barisdinc/Aselsan_Boynuz/3D/Rotary/README.md

## Frekans ve Menü İşlemleri için Rotary Encoder

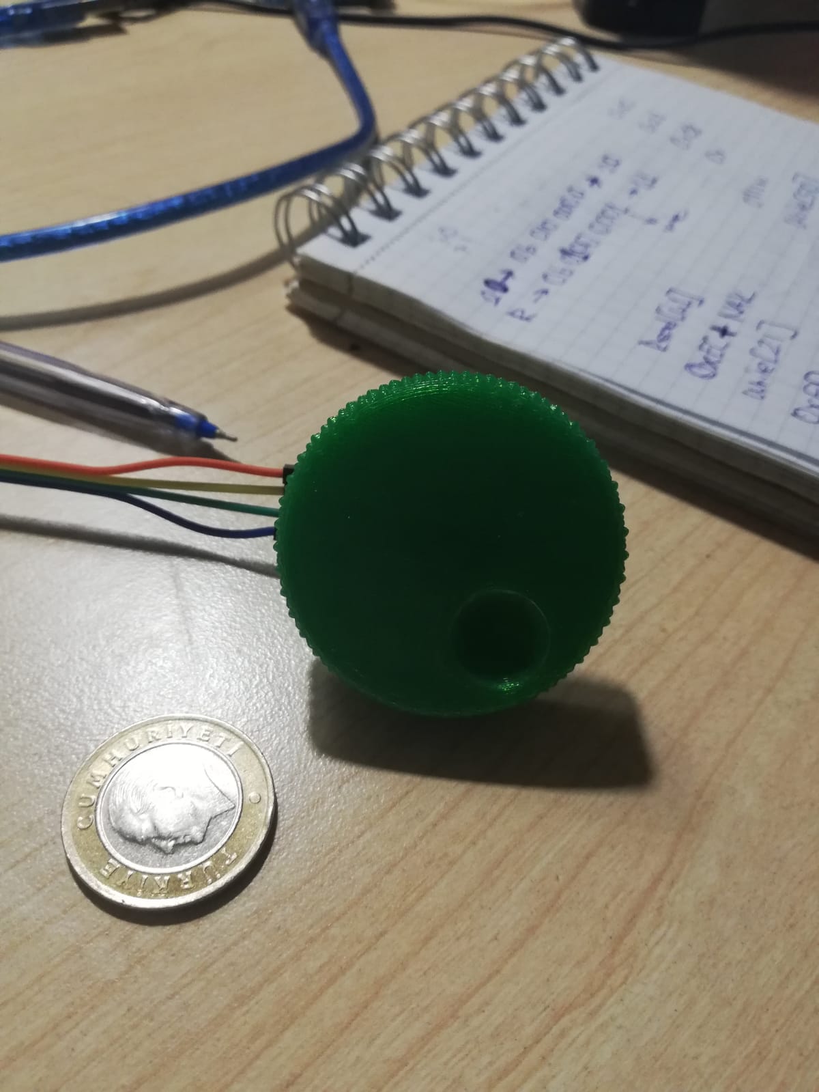
[picture p4: 3D/Rotary/Rotary-1.jpeg]
Rotary Encoder Knob 1


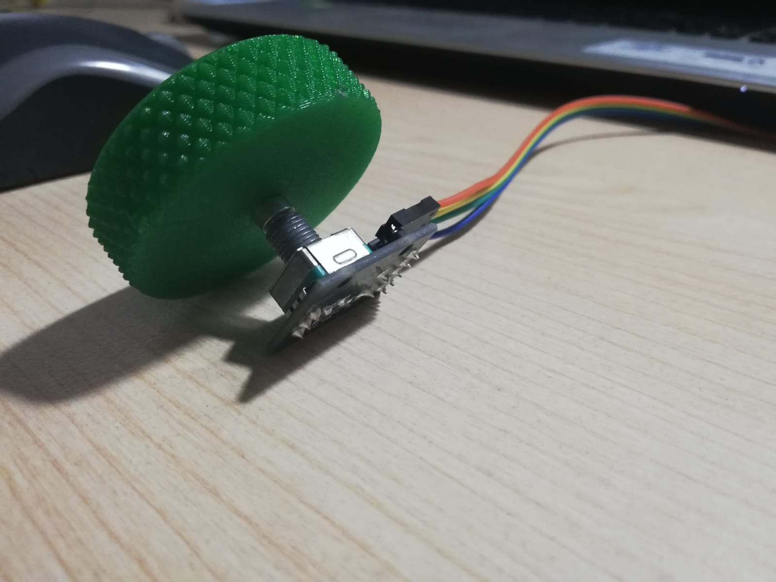
[picture p5: 3D/Rotary/Rotary-2.jpeg]
Rotary Encoder Knob 2


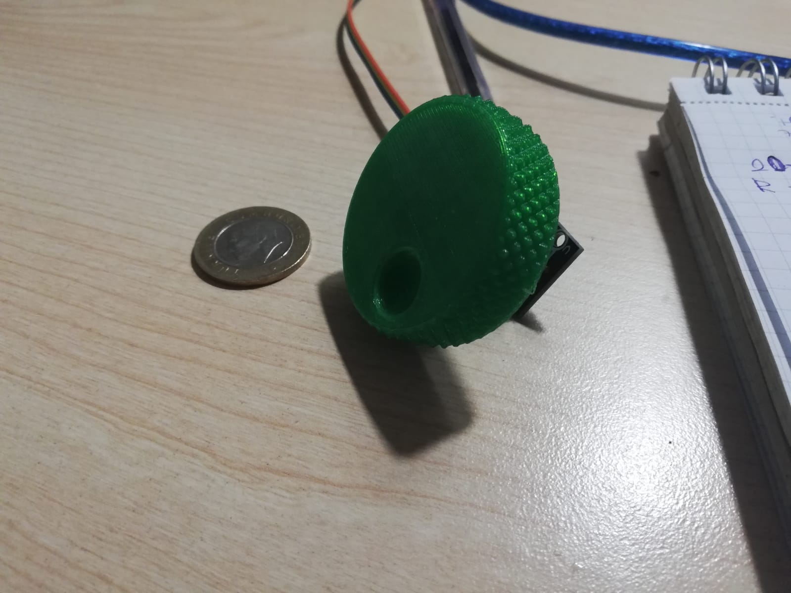
[picture p6: 3D/Rotary/Rotary-3.jpeg]
Rotary Encoder Knob 3
