barisdinc/Aselsan_Boynuz/Donanim/README.md

Aselsan LCD Segment yapısı ve Segment Mapleme Konusunda çalışma karalamaları eklendi.

Aselsan MCU'dan gelen veriyi decode edip USB seri port aracılığı ile PC'ye gönderen arduino kodu eklendi. (Şimdilik sadece rakamları ve K ve KN harflerini tanıyabiliyor)

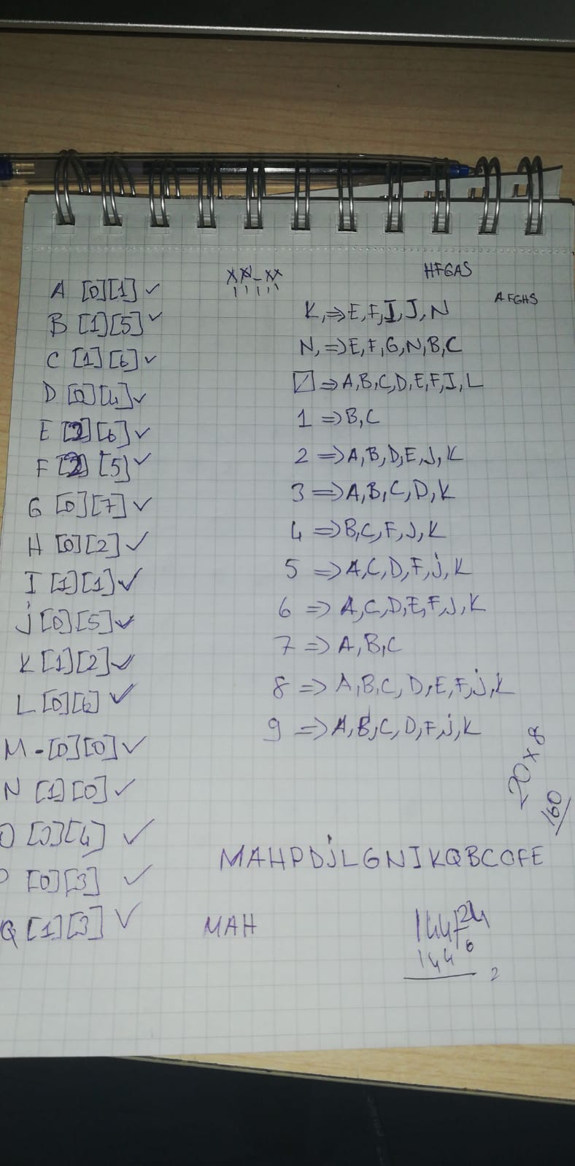
[picture p7: Donanim/Calisma/segment_1.jpeg]
Segment

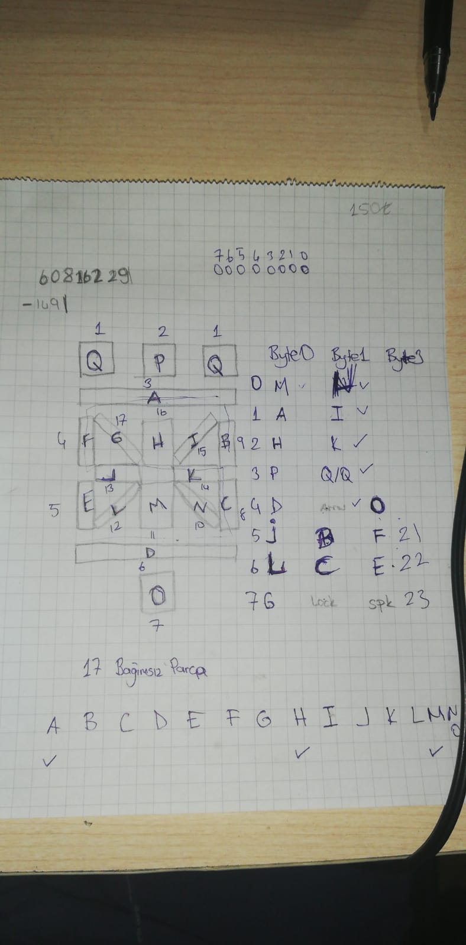
[picture p8: Donanim/Calisma/segment_2.jpeg]
Segment

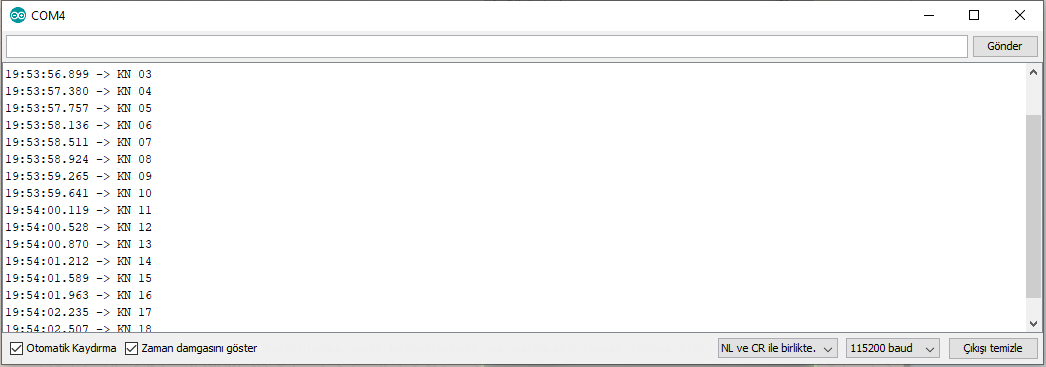
[picture p9: Donanim/Calisma/image.png]


##Boynuz Tuş Takımı Yapısı

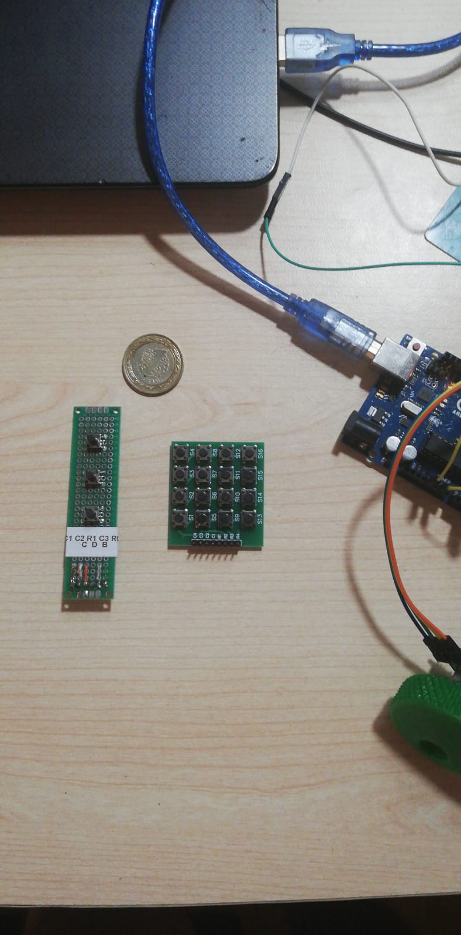
[picture p10: Donanim/Calisma/KeyPad/KP_1.jpeg]

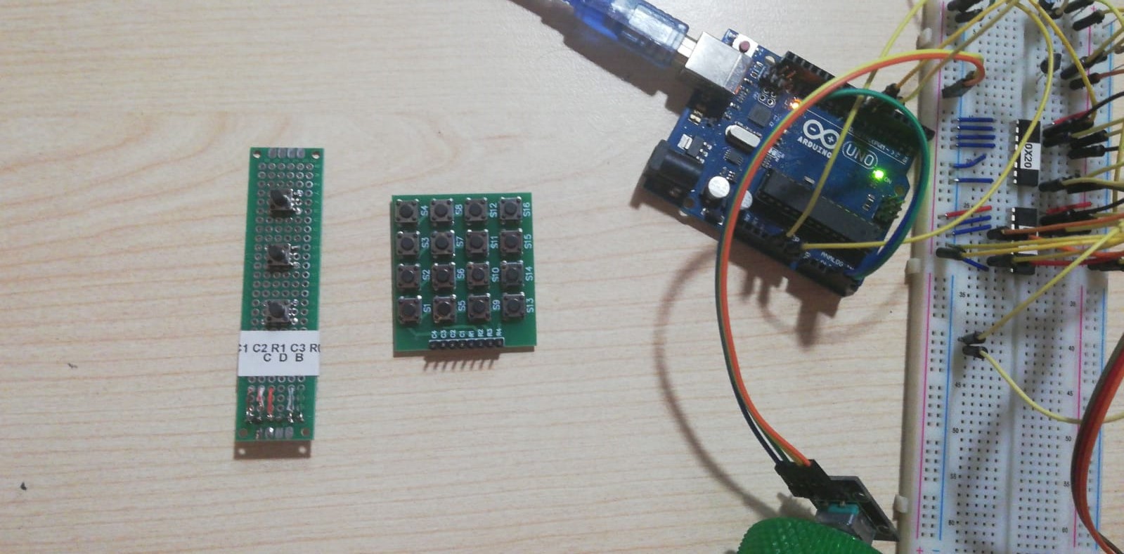
[picture p11: Donanim/Calisma/KeyPad/KP_2.jpeg]

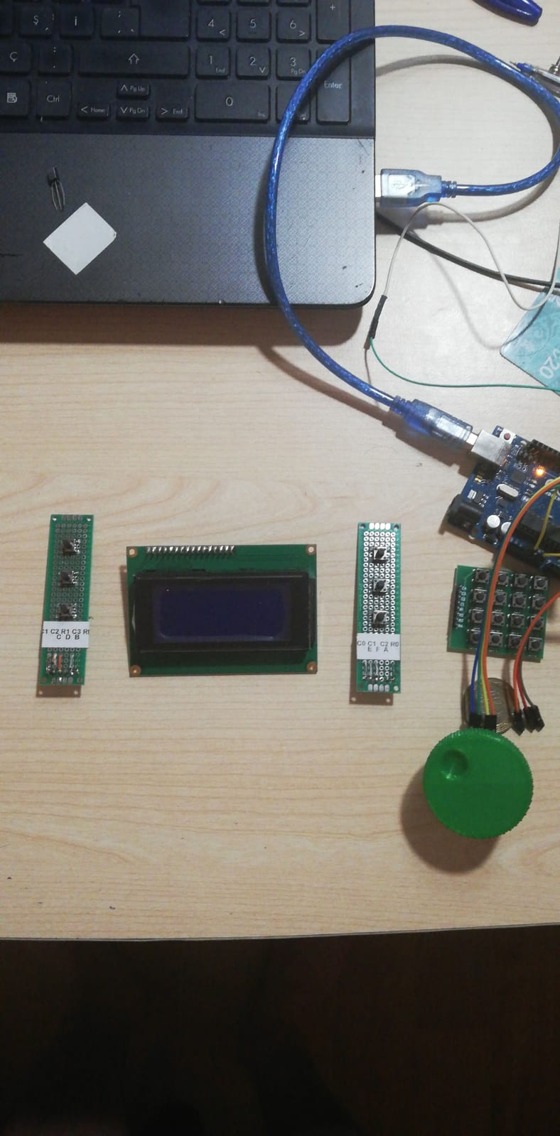
[picture p12: Donanim/Calisma/KeyPad/KP_3.jpeg]
