barisdinc/Aselsan_Boynuz/BilgisayarYazilimi/SegmentGenerator/README.md

Kullanılacak olan karakter için aktif olması gereken segmentlerin harfleri açık segmentler text'ine girilir.

Sonuç text kutusuna görülen değer karakterimizin karşılığıdır.

Örneğin ,

7 rakamını yazmak için A,B,C segmentlerinin açık olması gerekir.
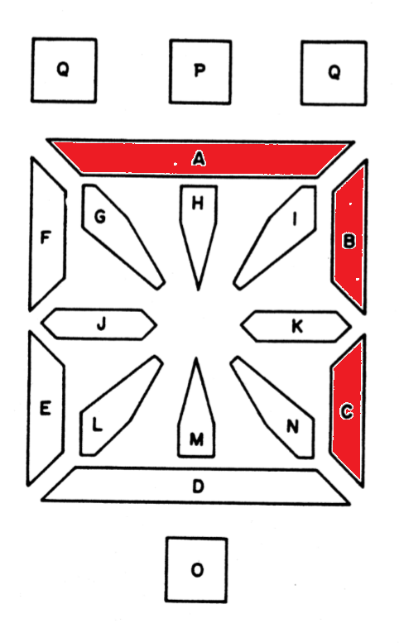
[picture p13: BilgisayarYazilimi/SegmentGenerator/image.png]
Segment


Bu da 20 bitlik karakter kodunda 0,1 ve 2. bitlere denk geliyor.

Sonuç olarak 7 rakamının karşılığı 11100000000000000 oluyor.

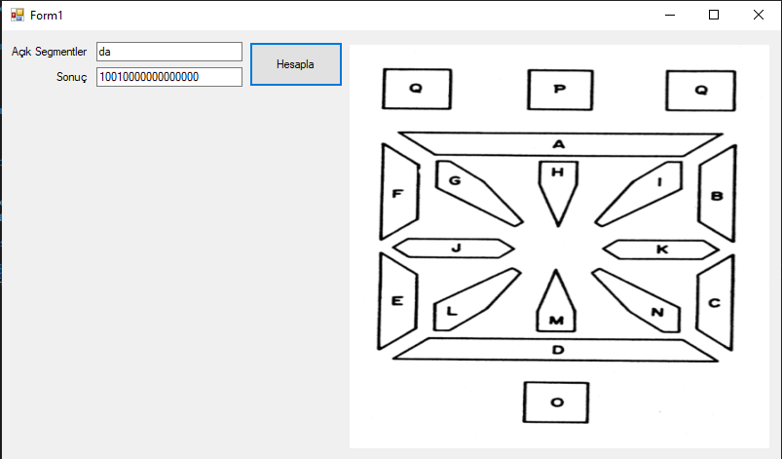
[picture p14: BilgisayarYazilimi/SegmentGenerator/SegmentGeneratorSS.png]
Segment2
