barisdinc/Aselsan_Boynuz/BilgisayarYazilimi/SegmentGenerator/AselsanSegmentGenerator/AselsanSegmentGenerator/Resources/asellcd.png

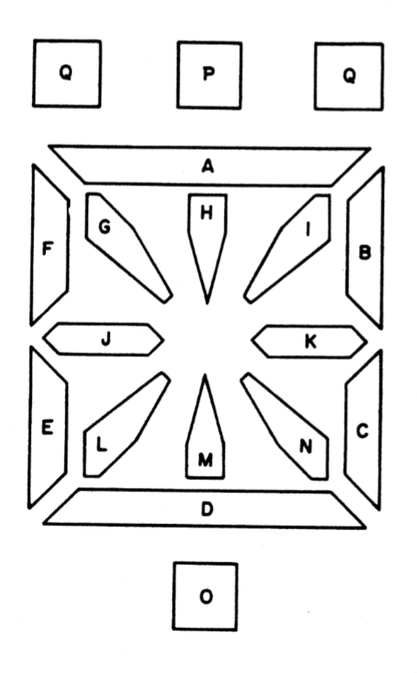
BilgisayarYazilimi/SegmentGenerator/AselsanSegmentGenerator/AselsanSegmentGenerator/Resources/asellcd.png
