barisdinc/Aselsan_Boynuz/Donanim/Tasarim/Tasarim_1.jpg

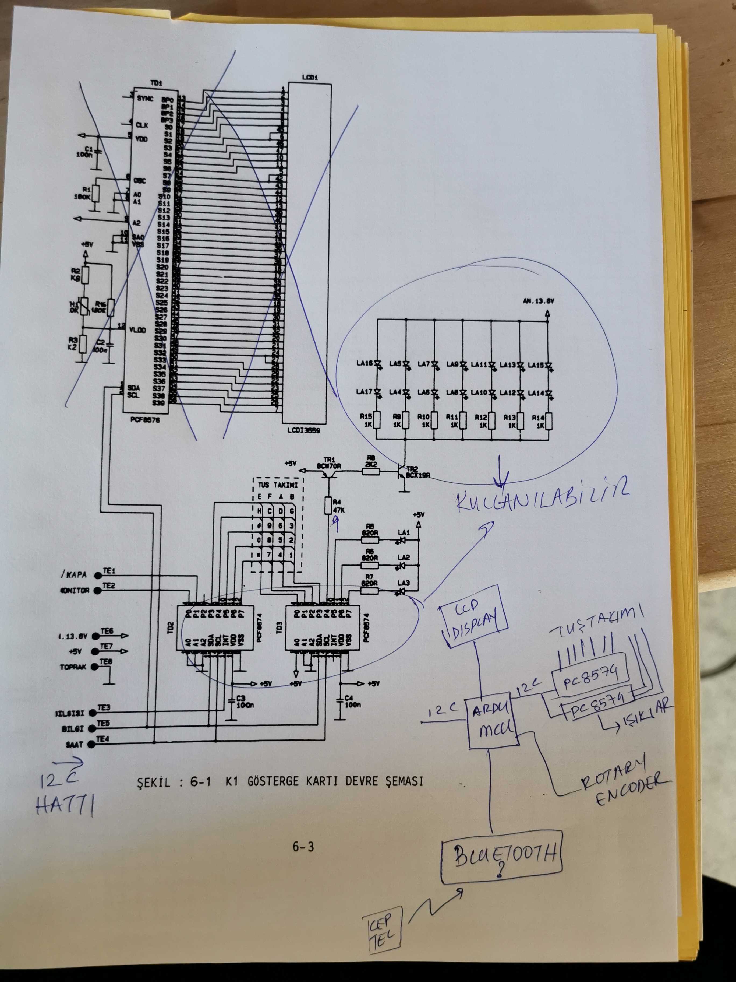
Donanim/Tasarim/Tasarim_1.jpg
