barisdinc/Aselsan_Boynuz/3D/Rotary/Rotary_Knurled.stl

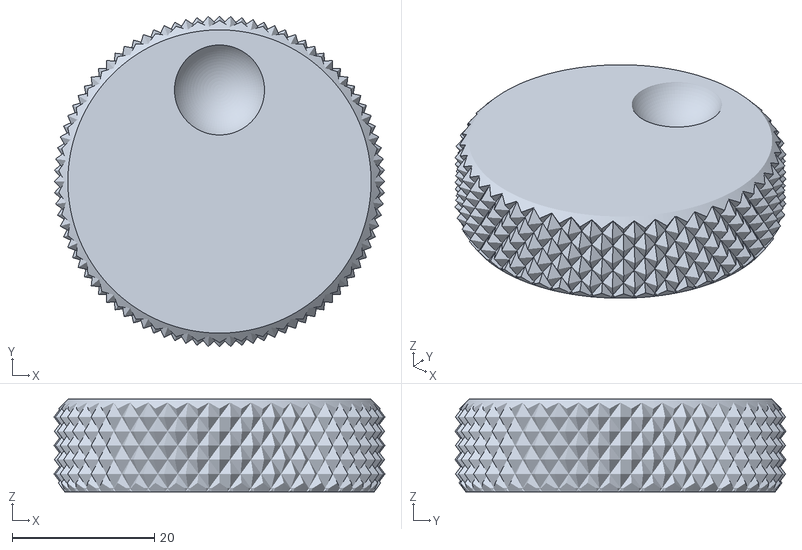
[picture p17: CAD file, 2020-08-06]
3D/Rotary/Rotary_Knurled.stl
46.5 x 46.5 x 13.0
