barisdinc/Aselsan_Boynuz/(threads)

Thread 3 (2020-07-12):

I2C Protokol Çözümlemesi

ToygarVarli, 2020-07-12:
Herkese merhaba ,

Orjinal aselsan donanıma sahip bir cihaz ile boynuz için Arduino nano ile çalışmaya başladım.  İlk aşamada 2.4 inchlik bir touch lcd ile aselsan MCU'dan gelen verileri ekrana yazdırmaya çalışıyorum.

Arduino 'yu LCD Slave adresi olan (0x38)'e slave olarak I2C hattına dahil ettim ve Aselsan MCU'dan gelen datayı arduino ile dinleyip seri porttan pc ekranına yazmaya başladım.

Ekrana KN 01 yazmak için MCU'nun gönderdiği değerler ,

`228 192 0 32 3 104 14 22 0 0 5 38 38 0  96 0  0 0 0 0 0 0 `

şeklinde.

Tamsat kitinin LCD'ye gönderdiği değerler ise

`5 3 128 128 225 96 0 0 0 18 96 96 0 98 0`

 Fakat bu datayı nasıl decode edeceğim konusunda yardıma ihtiyacım var.

Tamsat kitinden gelen datayı binary olarak çevirdiğim zaman fonts dosyasındaki uygun byte'ları bulabiliyorum (örn , K harfi B00000101, B00000011, B0000000 'Den oluşuyor   bu da => 5 = 101 , 3 => 11  şeklidne decode edebiliyorum.)

barisdinc, 2020-07-12:
Bunun icin semaya birazcik bakabilirsin...
https://github.com/barisdinc/ASELSAN_4822/blob/master/docs/4822-0002_MV4822-MV4826_AT_Bakim_Onarim_A3.pdf
dokumaninin K1 Gosterge kartina bakarsan I2C hattinin hem LCD surucusune hem de TUS takimini okuyan devreye bagli oldugunu gorursun (keza tus takiminin bir kismi LED lere ve aydinlatmaya da bagli ve I2C uzerinden suruluyor)

https://github.com/barisdinc/ASELSAN_4822/blob/master/docs/4822-0002_MV4822-MV4826_AT_Bakim_Onarim_RevA.pdf
dokumaninda sayfa 175 daha detayli aslinda...

tus takimi icin PCF8574 den 2 tane var... birine satir bilgisini yaziyor, sonra da surunlardan hangilerine karsilik geldigini okuyor.. cakisan yerlerdeki tuslara basilmis oldugunu anliyoruz...

adres kismina bakacak olursan da A0 A1 pinlerinin birinde topraga cekildigini gorursun.. detaylar icin PCF8574 datasheet ine bakabilirsin (https://github.com/barisdinc/Aselsan_Boynuz/blob/master/Docs/pcf8574.pdf    ADRES 0100-A2-A1-A0  yani adresi 20 21 22 ve 23 olabiliyor... semaya bakinca da sekil 6-1 sayfa 6-3 (179) birinde A2-A1-A0 in 000 digerinde 001 oldugunu gorursunyani birinin adresi 20 digeri 21)

LCD icin ise dokuman https://github.com/barisdinc/Aselsan_Boynuz/blob/master/Docs/PCF8576.pdf
bunun adresi de 0111000 ve yine A0 A1 A2 ama hepsi toprakta.. yani adresimiz 70h)

bu bilgilerre ASELSAN kodumuzdaki 60. satir civarinda asagidaki gibi e ulasabilirsin

#define PCF8576_LCD         0x38 //B111000   // This is the address of the PCF on the i2c bus
#define PCF8574_KEYB        0x20 //PCF854 connected to LED and KEYBOARD
#define PCF8574_KEYB_LED    0x21 //PCF8574 connected to KEYBOARD and has interrupt connected to MCU

sumdi bu ne demek...
krana ne yazildigini takip edecek isek 0x38 adresine slave olmaliyiz, tus takimini dinleyecek ya da isiklari yakacak isek de 20 ve 21'e... mantiklarini ve ilseyisini bilahare baska bir issue kapsmainda tartisidriz..

Gelelim LCD yi anlama konusuna. .bunun icin 8576 nin PDF ini iyi hatim etmek lazim.. Font memory si, registerlari ne demek diye... Neticede orjinal aselsan kodu baska registerleri kullanarak islemis olailir.. ben direk PDF den isime yarayanlari kullandim.. BOYNUZ icin sanki en kolay kullanim su sekilde olabilir (temel mantik aslinda I2C den paralel olarak pinlere segmentler halinde veri basmak):

Sekil 6-1 e ek olarak sayfa E-9 (330 ve 331) e bakmani oneririm... burada hangi bacaklara hengi ekran pinlerinin bagli oldugunu builursun..

Ben bu pinlere karsilik gelen yapida kendimce bir FONT yapisi uydurdum, ama sanirim orjinal aselsan baska birseyler yapmis ama onemli degil neticede dogru registerleri dinlersek ya da ekranda hangi yerleri yakacagimizi bilirsek ilerleyebiliris.

kolay olmasi acisindan sivi kristal gostergedeki gibi 18 parcali harflerden ve bunlarin sira ile yakilmasindan ilerlemeliyiz...
LCD surucu komutlari datasheet inin 23. sayfasindan itibaren basliyor

ToygarVarli, 2020-07-12:
Merhaba Barış Hocam ,

Evet söylediğiniz gibi arduino'yu i2c hattına slave gibi dahil edip MCU'dan LCD'ye gelen veriyi arduino'da karşılayıp sonrasında da LCD'ye yazdırmaya çalışıyorum.

Döküman referanslarını okumaya başladım ilerleme katedebilirsem mutlaka bilgi veriyor olacağım.

Teşekkürler.

ToygarVarli, 2020-08-03:
Hocam selamlar ,

Bir süredir çalışmaya devam ediyorum , uzun ve sıkıcı bir yazı yazıp bayram tatilinden dolayı olmayan pazartesi sendromunu yazımla hortlatmak isterim :)

Bizim tamsatta kullandığımız K harfi ,

Görüntüdeki K harflerinden soldaki. Aselsan MCU'nun gönderdiği sağdaki.  Aselsan 1 segment daha fazla yakıyor kısacası.
Zaten önceki mesajınızda da font dosyasını ihtiyacımızı görecek şekilde oluşturduğumuzu **bundan dolayı farklılıklar olabileceğini konuşmuştuk**.

Fakat boynuz'un hem tamsat hem de orjinal aselsan cihazlarla çalışabilmesi için fontların aynı olması gerekiyor diye düşünüyorum.

Bu yüzden tamsat içindeki K harfini aselsan'daki K harfi ile aynı yaptım.  Böylece orjinal aselsan'ın I2C'den gönderdiği değerleri tamsat'ın oluşturduğu değerler ile karşılaştırırken işimi kolaylaştırıyor.

```
 B00100000, B00000011, B01101000, //K - Tamsat
 B00100000, B00000011, B01100000, //K - Aselsan
```
şeklinde güncelledim.

Aselsan'ın K harfi için oluşturduğu binary değelerin HEX karşılıklarına bakalım ,

`0x20 , 0x03 , 0x60`

Fakat aselsan ekrana KN yazmak için

`0x20 , 0x03, 0x68 , 0x0E , 0x16, 0x00`

değerlerini gönderiyor.

Yani K harfi için font mappinginde son değer 0x60 olmasına rağmen aselsan 0x68 gönderiyor.

Arduino ile LCD'ye 0x20,0x3,0x68 gönderdiğim zaman ise sonraki karakterin bir parçasının da aydınlandığını görüyorum. (testimiz özelinde n harfinin g segmenti)

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

Bizim tamsatta kullandığımız lcd font oluşturma kısmında

`    if (idx > 0) {                       //third BYTE should include previous character if this is not the first
      matrix[3 * idx + 2] = font[(pos * 3) + 2] | (matrix[3 * (idx + 1)] & B00001111) | Position_Signs[idx][2]; // four bits should be from the existing character
    }`

şöyle bir işlemimiz var.

3.Byte bir **önceki** karakterden 4 bit içerir şeklinde. Fakat aselsan sanki 3.byte bir **sonraki** karakterden 4bit içerir gibi bir logic ile ilerlemiş. Tabii eğer bu tespitim doğru ise bizim tamsatta kullandığımız 1 karakter için 3 byte array oluştur bunu LCD'ye yolla , sonra sonraki karaktere geç logic'inin değişmesi gerekiyor gibi çünkü her 20.bit'ten sonra bir sonraki karakterin bitleri gelmeye başlıyor.

Tüm tespit ettiğim / ettiğimi sandığım konuları toplayacak olursam şöyle bir teorim var.

Her karakterin 20bit gerektirdiğini biliyoruz zaten.

Ama biz 3 bytelık arrayler oluşturduğumuz için 24bit oluyor aslında.

Ekrana TAMSAT yazmak istediğimizi düşünürsek ,

Elimizde 6x3 byte = 18 byte oluyor.

İlk 3 byte'ın 20 biti T harfi için. Kalan 4 bit de A harfinin ilk bytenın 4 bitini içermeli.

Bu durumda 18 bytelık arrayi 3er 3er göndermek yerine önce 18 byte'ı oluşturmalı ,

Sonra da bitwise işlemleri ile her 20bitte bir sonraki byte'ın 4 bitini bir önceki byte'ın son 4 bitine yazmalıyız. ve LCD'ye gönderirken 18 byte'ı tek seferde yollamalıyız. (Burada bahsettiğim bitwise işlemi nasıl yapabileceğim konusunda pek fikrim yok açıkcası)

gibi değişik bir sonuca ulaşıyorum.

Şimdilik tespit edebildiğim kısımlar bunlar. Bunları paylaşıp değerli yorumlarınızı  almak isterim.

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

Closed 2020-08-03.

Thread 5 (2020-08-03):

Donanım ile İlgili Kararlar

ToygarVarli, 2020-08-03:
Barış Hocam Selamlar ,

Elimde bulunan 2.4 inch TFT touch  LCD ile Aselsandan gelen bilgileri görüntüleyebiliyorum artık :)

Fakat elimdeki arduino uno'nun neredeyse tüm pinlerini işgal ediyor.

LCD olarak nasıl bir şey kullanacağız ? Bununla ilgili bir karar var mı acaba ? (Büyüklüğü , haberleşme türü v.s)

Nextion HMI'lar var. Fiyatları biraz yüksek ama , basit bir program ile kullanıcı kendi arayüzlerini tasarlayabiliyor.

Ayrıca boynuz'daki mcu olarak atmega328 mi kullanacağız ?

-Ayrıca aydınlatma ve tuş takımı için 2 adet daha i2c slave olmalı. Bu durumda arduino'yu totalde 3 farklı slave olarak tanıtmamız gerekecek.

2.4 lcd ile çalışmamdan bir kare.

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

barisdinc, 2020-08-04:
Merhabalar, aslinda boynuz icinde buluncak islemci icin ARDUINO (atmel) ya da benzeri bir kisitimiz yok.. dogrusunu istersen zamaninda hurdanan aldigim birkacbin tane MSP430 lari degerlendirmeyi de dusunuyorum bu proje icin bir yandan...
o yuzden ekran icin de cok bir kisitimiz yok.

aydinlatma ve tus takimi konusund haklisin...

ToygarVarli, 2020-08-04:
Hocam peki ekran olarak grafik lcd kullanabilir miyiz?

Elimde 240x128 bir grafik lcd var. Arkasında da i2c backpack mevcut. 2 pin ile olayı çözebiliriz. Siz readme dosyasında renkli lcd olarak madde yazmışsınız o yüzden bende bu tarz lcd ye yönelmiştim. Grafik lcd kullanabilirsek harika olur.

Msp430 konusunda ise elimde,

exp430fr4133 geliştirme kiti ve

MSP430G2xxx launch pad mevcut.

Bu mcular ile çalışabilir miyiz? Texas tarafına çok hakim olmadığım için mcu bazlı değişiklikler oluyor mu emin değilim.

Yönlendirebileceğiniz spesifik bir mcu var ise onu edinmeye çalışıp oradan da devam edebilirim.

barisdinc, 2020-08-04:
dedigim gibi , bir kisitlamamiz yok.. Amacimiz en uygun butce ile en verimli cihazi yapmak.
elimde msp430fe4272ipmr, msp430fe425aipmr  ve msp430f436ipzr var.

haliyle herhangi bir MSP430 ile calisma yapabiliriz, daha sonra diger islemciye port etmek kolay olur.. sanirim cok detay donanimsal kodlama (timer secimi, vb.) yapmayiz.

sadece derleyici olarak GCC ya da open birsey kullanmayi tercih ederim, herkes ulasabilir olsun diye

ToygarVarli, 2020-08-04:
Tamamdır hocam ,

O halde elimdeki kaynaklar projede çalışmak için yeterli. (MSP430 ve Grafik LCD)

MSP430'ları programlarken Energia IDE kullanıyordum hocam ben.

Bildiğim kadarı ile GCC ile derliyor ve arduino gibi library desteği vs açısından da oldukça zengin. Sakıncası yok ise buradan devam edeyim ?

barisdinc, 2020-08-05:
Evet GCC kullaniyormus... onunla devam edebilrisin..

kolay gele

ToygarVarli, 2020-08-06:
Teşekkür ederim hocam.

Closed 2020-08-06.

Thread 7 (2020-08-06):

Ses Ayar Potu

ToygarVarli, 2020-08-06:
Barış Abi selamlar,

Telsiz in up down butonunu rotary encoder ile değiştirmeyi düşünüyoruz planlama olarak.

Fakat ses ayarlama için de bir pot olması gerekir mi?

Ya da rotary encoder için switchli bir model kullanarak ana ekranda iken Switch e basıldığı zaman rotary i kanal değiştirme/ses ayarlama modları arasında geçiş mi yapsak?

barisdinc, 2020-08-06:
Ses ayar POT'u analog bir devreye bagli, o yuzden onu digital olarak kontrol edebilmek icin direnci sigital kontrol edilebilen pot IC lerinden kullanmaliyiz. Pek cok audio cihazinin icnde var bunlar...

Dogrusunu istersen sesi sayisal olark kontrol etmeyi cok dusunmemistim ama nedne olmasin.. (maliyeti arrtiracagini da unutmamak lazim)
ornek :
PT2258
PGA2320
MAX5486
DS1669

ToygarVarli, 2020-08-06:
Abi selam,

Digital pot entegrelerini gördüm fakat maliyetten dolayı bir arka kapı bulmak için internette biraz araştırma yaptım,

Pwm sinyalini low pasa filter den geçirerek digital bir potansiyometre gibi kullanılabileceğine dair bir konu okudum.

İş görür mü emin değilim ama,

https://arduino.stackexchange.com/questions/1844/how-to-emulate-an-analog-potentiometer-with-pwm

Haktan-OE, 2020-08-07:
Toygar Hocam,

Teknik olarak pwm sinyalini low pass filter'dan geçirerek böyle bir kullanım yapmanız mümkündür. Bu uygulama basit robotik çalışmalarda motor kontrol fonksiyonları için de kullanılmaktadır. Maliyet açısından da sonuç açısından da bu kullanımın işinizi göreceğini düşünmekteyim. Tabi ki Barış Abi konuya çok daha hakim, son söz her zaman kendisinindir :) Saygılarımla

ToygarVarli, 2020-08-07:
Haktan Hocam Selamlar ,

Cevabınız için çok teşekkür ederim ,

Ayrıca projeye bir contributor daha katılmış olmasına çok memnun oldum :)

Thread 9 (2020-08-11):

Boynuz Devre Tasarımı

ToygarVarli, 2020-08-11:
Herkese Merhaba ,

Boynuz projesi kapsamında yeni yapacağımız kasa içerisinde bir devre olması gerektiğini düşünüyorum.

Bu devrenin de 5V regülasyon katı , Tuş Takımı için PCF8574 I2C katı olması gerekiyor haliyle.

Aşağıdaki gibi bir devre tasarladım. Transistörler UP/DOWN fonksiyonu için mekanik switch gibi kullanılıyor.

Çünkü Boynuz mcu'sunun digital pinlerini kullanarak direkt olarak PCF'lerde istediğim tuşa bastıramadım.

-Sebebinin de 0x20'den interrupt aldıktan sonra aselsan mcusunun 0x20nin pin statelerini değiştirip 0x21'i okuması olduğunu düşünüyorum.

Elektronik mühendisi olmadığım için devre hakkında görüş/öneri/eleştirilerinizi bekliyorum.

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

barisdinc, 2020-08-11:
Merhaba,

Bir devre konusunda haklisin, henuz detaylarini cok fazla dusunmedigimi itiraf edeyim. Kullanacagimiz islemcinin bacaklarinin cogunun bosta kalacagini dusunerek dogrusunu istersen direk IO pinlerine baglariz diye dusunmus idim. 4x4 tus takimina 8 pin yeterli olacaktir.

devreyi anlayabilmek icin birkac sorum olcak :
- J1 nerden geliyor  (MCU tarafindan oldugunu dusunuyorum, keza cihaz uzerindekji DB15 de UP/DOWN yok)
- PCF8574 lerin pinlerini transistor uzerinden birbirine baglamanin amacini tam olarak anlayamadim :(

mevcut tus takimindaki calisma presnsibi su sekilde,
- MCU hangi satiri okuyacak ise o satira 1. PCF uzerinden sinyal veriyor sonra da basili olan tusu anlamak icin 2. PCF nin pinlerinin durumunu okiuyor.. bu o satirda hangi tusa basilmis oldugunu soyluyor,
- bu islem 4 satir icin tekrarlaniyor

Ancak bizim yapacagimiz I2C hattindan MCU yu dinleyip, GPIO lar ile okudugumuz tus takimlarinin bilgisini dogru forma sokup geri gondermek olmali.
- basilan tus bilgisi alinip 4x4 luk bir matrise yerlestirilir
- ana cihaz MCU sunun sordugu (0x20) satir bilgisi tek boyutlu bir diziye alinir
- bu tek boyutlu dizi 0x21 sorgusuna cevap olarak PCF bilgisi gibi formatlanip gonderilir.

en azindan ben boyle dusunmustum

ToygarVarli, 2020-08-11:
Barış Abi Selamlar ,

- J1 Aslında Boynuzda kullanacağımız MCU tarafını simgeliyor. (MSP430 , Atmega328 ikisinde de çalıştığım için o tarafı açık bıraktım)

-PCF8574'lerin pinlerini transistör üzerinden bağlama sebebim ise transistorün base'ini HIGH yaptığım zaman collector ve emiter de HIGH oluyor. Böylece aslında fiziksel bir switch'e basılmış gibi oluyor. A pinleri satırı tetikliyor , B pinleri sütunları.

UP yapmak için 0x20 'de P3 , 0x21'de P0'ın tetiklenmesi lazım. Bu söylediğim durumu arduinonun iki digitalPinini kullanarak yapmayı denediğim zaman bir türlü başarılı bir sonuç elde edemedim.

Abi şöyle düşündüm aslında ,

Biz boynuz mcusu ile tuş takımını okumak için ekstra bir efor sarfetmemeliyiz gibi. Orjinal kafadaki tuş takımı devresini boynuza taşıyıp UP/DOWN manipülasyonunu yapıp kalanı orjinal işleyişe bırakabiliriz. Çünkü tuş takımının göndereceği veri aslında aynı kalacak.

Böyle söyleme sebebim ise şu ,

I2C hattında 0x38 , 0x21 , 0x20 olmalıyız söylediğiniz yöntem ile ilerleyecek olursak. Bu durumda AVR/MSP mcularımız tek bir I2C hattı mevcut ve 1 tane slave olabiliriz olarak anlıyorum.

Runtime esnasında Slave olduğumuz zaman kod çalışırken slave adresimizi değiştirme ile ilgili bir yol yordam bulamadım.
Slave address masking yapabiliriz.(AVR MCU'larda TWAMR ile yapılabildiğini okudum) Yani 3 slave adresini de aynı anda dinleyebiliriz ama sanırım pek efektif bir yol değil gibi. Yani en azından ben çalışmalarımda 3 slave'i de aynı anda dinleme sırasında stabil bir çözüm elde edemedim.

ToygarVarli, 2020-08-11:
Barış Hocam Selamlar ,

An itibari ile çalışma masama erişimim oldu.

Logic analyzer ile Orjinal aselsan MCU'nun Down butonuna basıldığında oluşan paketleri izledim.

0x20'den read işlemleri var. Fakat 0x21'den read işlemi göremedim. Sol taraftakiler Write , Sağ taraftakiler Read işlemleri.

Logic Analyzer'ın da Excel exportunu ekte iletiyorum.

[ButtonDown.xlsx](https://github.com/barisdinc/Aselsan_Boynuz/files/5058032/ButtonDown.xlsx)

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

barisdinc, 2020-08-11:
Selam,

Benzer incelemeyi zamaninda ben de yapip 4822 kodunun icinde basitce benzetmesini yapmistim.
Hatta daha sonra (ilk emir oku olmasina ragmen) kitabini okudugumda da detaylica aciklandigini gordum.
BOYNUZ projesi icin vaktin oldukca bakim klavuzunu okumani oneririm, sade bir dille ama cok detaylica yazilmis.

Bakiniz
BOLUM 3-6 IIC HABERLESME YOLU (sayfa 88)
BOLUM 3-15 TUS TAKIMI (Sayfa 98)
K1 GOSTERGE KARTI (Sayfa 175)  (BU BOLUM ONEMLI)

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

Kolay gele
