barisdinc/Aselsan_Boynuz/(commit log)

2020-08-05 Add files via upload
    PC8574 Advanced Datasheet Includes Read , Write Data Frames and Responses
2020-08-10 Ekran Yanı Tuş Takımı Görüntüleri Eklendi , Rotary Encoder ile Kanal-Frekans Değişimi Uygulaması Yapıldı
